schang266-crypto/Area-Efficient_GEMM_Core_for_Neural_Network_Inference_on_the_Edge/DesignDiagrams/fp16_adder_comparasin.png

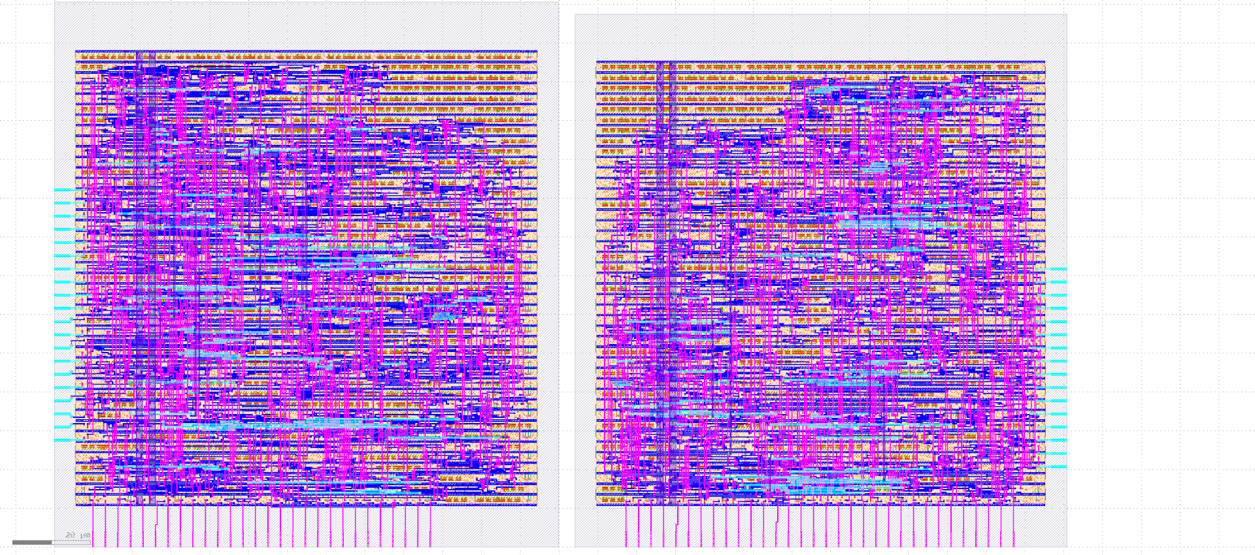
DesignDiagrams/fp16_adder_comparasin.png
