schang266-crypto/Area-Efficient_GEMM_Core_for_Neural_Network_Inference_on_the_Edge/DesignDiagrams/TOP2.png

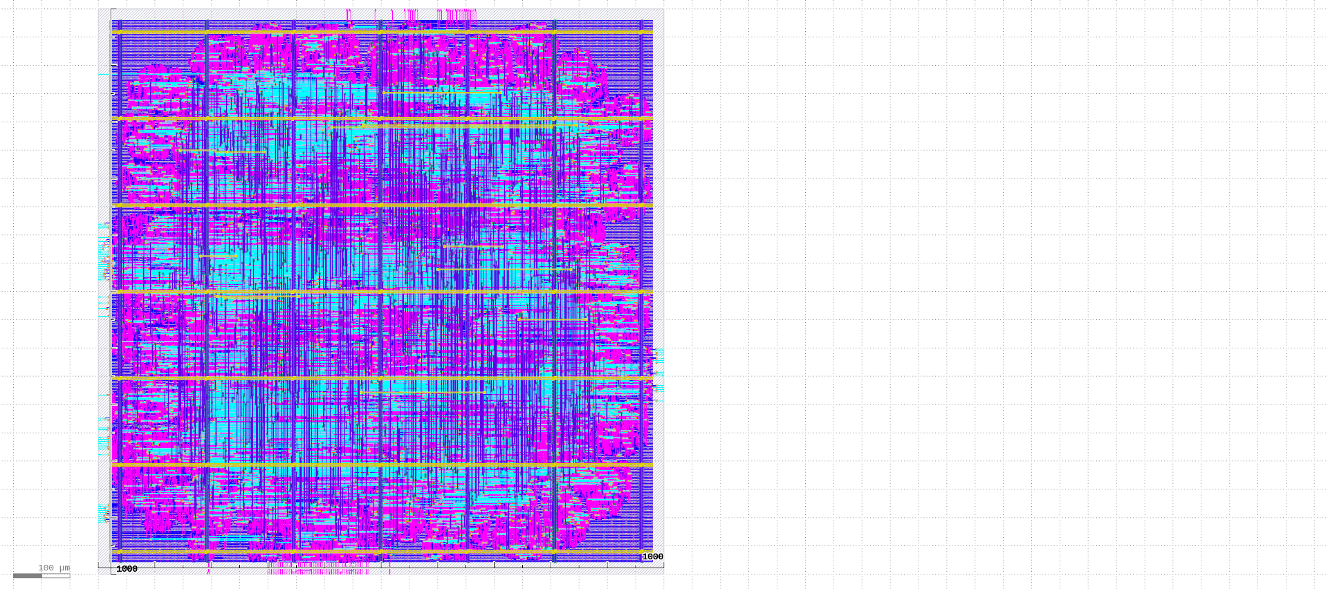
DesignDiagrams/TOP2.png
