schang266-crypto/Area-Efficient_GEMM_Core_for_Neural_Network_Inference_on_the_Edge/Synthesis/gemm_pe/gemm_pe.nl.v

module gemm_pe (clk,
    h_en_in,
    h_en_out,
    ld_bias,
    v_en_in,
    v_en_out,
    a_in,
    a_out,
    acc_out,
    bias,
    w_in,
    w_out);
 input clk;
 input h_en_in;
 output h_en_out;
 input ld_bias;
 input v_en_in;
 output v_en_out;
 input [3:0] a_in;
 output [3:0] a_out;
 output [15:0] acc_out;
 input [15:0] bias;
 input [3:0] w_in;
 output [3:0] w_out;

 wire _0000_;
 wire _0001_;
 wire _0002_;
 wire _0003_;
 wire _0004_;
 wire _0005_;
 wire _0006_;
 wire _0007_;
 wire _0008_;
 wire _0009_;
 wire _0010_;
 wire _0011_;
 wire _0012_;
 wire _0013_;
 wire _0014_;
 wire _0015_;
 wire _0016_;
 wire _0017_;
 wire _0018_;
 wire _0019_;
 wire _0020_;
 wire _0021_;
 wire _0022_;
 wire _0023_;
 wire _0024_;
 wire _0025_;
 wire _0026_;
 wire _0027_;
 wire _0028_;
 wire _0029_;
 wire _0030_;
 wire _0031_;
 wire _0032_;
 wire _0033_;
 wire _0034_;
 wire _0035_;
 wire _0036_;
 wire _0037_;
 wire _0038_;
 wire _0039_;
 wire _0040_;
 wire _0041_;
 wire _0042_;
 wire _0043_;
 wire _0044_;
 wire _0045_;
 wire _0046_;
 wire _0047_;
 wire _0048_;
 wire _0049_;
 wire _0050_;
 wire _0051_;
 wire _0052_;
 wire _0053_;
 wire _0054_;
 wire _0055_;
 wire _0056_;
 wire _0057_;
 wire _0058_;
 wire _0059_;
 wire _0060_;
 wire _0061_;
 wire _0062_;
 wire _0063_;
 wire _0064_;
 wire _0065_;
 wire _0066_;
 wire _0067_;
 wire _0068_;
 wire _0069_;
 wire _0070_;
 wire _0071_;
 wire _0072_;
 wire _0073_;
 wire _0074_;
 wire _0075_;
 wire _0076_;
 wire _0077_;
 wire _0078_;
 wire _0079_;
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
 sky130_fd_sc_hd__dfxtp_2 _2408_ (.CLK(clknet_2_2__leaf_clk),
    .D(_0022_),
    .Q(acc_out[6]));
 sky130_fd_sc_hd__dfxtp_2 _2409_ (.CLK(clknet_2_2__leaf_clk),
    .D(_0023_),
    .Q(acc_out[7]));
 sky130_fd_sc_hd__dfxtp_2 _2410_ (.CLK(clknet_2_2__leaf_clk),
    .D(_0024_),
    .Q(acc_out[8]));
 sky130_fd_sc_hd__dfxtp_2 _2411_ (.CLK(clknet_2_2__leaf_clk),
    .D(_0025_),
    .Q(acc_out[9]));
 sky130_fd_sc_hd__dfxtp_2 _2412_ (.CLK(clknet_2_0__leaf_clk),
    .D(_0026_),
    .Q(acc_out[10]));
 sky130_fd_sc_hd__dfxtp_2 _2413_ (.CLK(clknet_2_1__leaf_clk),
    .D(_0027_),
    .Q(acc_out[11]));
 sky130_fd_sc_hd__dfxtp_2 _2414_ (.CLK(clknet_2_0__leaf_clk),
    .D(_0028_),
    .Q(acc_out[12]));
 sky130_fd_sc_hd__dfxtp_2 _2415_ (.CLK(clknet_2_1__leaf_clk),
    .D(_0029_),
    .Q(acc_out[13]));
 sky130_fd_sc_hd__dfxtp_2 _2416_ (.CLK(clknet_2_1__leaf_clk),
    .D(_0030_),
    .Q(acc_out[14]));
 sky130_fd_sc_hd__dfxtp_2 _2417_ (.CLK(clknet_2_1__leaf_clk),
    .D(_0031_),
    .Q(\u_fp16_add.sb ));
 sky130_fd_sc_hd__dfxtp_2 _2418_ (.CLK(clknet_2_1__leaf_clk),
    .D(pe_en),
    .Q(pe_en_q));
 sky130_fd_sc_hd__dfxtp_2 _2419_ (.CLK(clknet_2_1__leaf_clk),
    .D(_0032_),
    .Q(\mul_out_q[7] ));
 sky130_fd_sc_hd__conb_1 _2420_ (.LO(_0000_));
 sky130_fd_sc_hd__buf_2 _2421_ (.A(\u_fp16_add.sb ),
    .X(acc_out[15]));
 sky130_fd_sc_hd__decap_3 PHY_EDGE_ROW_0_Right_0 ();
 sky130_fd_sc_hd__decap_3 PHY_EDGE_ROW_1_Right_1 ();
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
