schang266-crypto/Area-Efficient_GEMM_Core_for_Neural_Network_Inference_on_the_Edge/Synthesis/gemm_pe/gemm_pe.pnl.v

module gemm_pe (clk,
    h_en_in,
    h_en_out,
    ld_bias,
    v_en_in,
    v_en_out,
    VPWR,
    VGND,
    a_in,
    a_out,
    acc_out,
    bias,
    w_in,
    w_out);
 input clk;
 input h_en_in;
 output h_en_out;
 input ld_bias;
 input v_en_in;
 output v_en_out;
 inout VPWR;
 inout VGND;
 input [3:0] a_in;
 output [3:0] a_out;
 output [15:0] acc_out;
 input [15:0] bias;
 input [3:0] w_in;
 output [3:0] w_out;

 wire _0000_;
 wire _0001_;
 wire _0002_;
 wire _0003_;
 wire _0004_;
 wire _0005_;
 wire _0006_;
 wire _0007_;
 wire _0008_;
 wire _0009_;
 wire _0010_;
 wire _0011_;
 wire _0012_;
 wire _0013_;
 wire _0014_;
 wire _0015_;
 wire _0016_;
 wire _0017_;
 wire _0018_;
 wire _0019_;
 wire _0020_;
 wire _0021_;
 wire _0022_;
 wire _0023_;
 wire _0024_;
 wire _0025_;
 wire _0026_;
 wire _0027_;
 wire _0028_;
 wire _0029_;
 wire _0030_;
 wire _0031_;
 wire _0032_;
 wire _0033_;
 wire _0034_;
 wire _0035_;
 wire _0036_;
 wire _0037_;
 wire _0038_;
 wire _0039_;
 wire _0040_;
 wire _0041_;
 wire _0042_;
 wire _0043_;
 wire _0044_;
 wire _0045_;
 wire _0046_;
 wire _0047_;
 wire _0048_;
 wire _0049_;
 wire _0050_;
 wire _0051_;
 wire _0052_;
 wire _0053_;
 wire _0054_;
 wire _0055_;
 wire _0056_;
 wire _0057_;
 wire _0058_;
 wire _0059_;
 wire _0060_;
 wire _0061_;
 wire _0062_;
 wire _0063_;
 wire _0064_;
 wire _0065_;
 wire _0066_;
 wire _0067_;
 wire _0068_;
 wire _0069_;
 wire _0070_;
 wire _0071_;
 wire _0072_;
 wire _0073_;
 wire _0074_;
 wire _0075_;
 wire _0076_;
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
    .VPB(VPWR),
    .VPWR(VPWR),
    .Y(_0958_));
 sky130_fd_sc_hd__inv_2 _1880_ (.A(_0958_),
    .VGND(VGND),
    .VNB(VGND),
    .VPB(VPWR),
    .VPWR(VPWR),
    .Y(_0959_));
 sky130_fd_sc_hd__nand2_2 _1881_ (.A(_0940_),
    .B(_0744_),
    .VGND(VGND),
    .VNB(VGND),
    .VPB(VPWR),
    .VPWR(VPWR),
    .Y(_0960_));
 sky130_fd_sc_hd__nand3_2 _1882_ (.A(_0945_),
    .B(_0745_),
    .C(_0926_),
    .VGND(VGND),
    .VNB(VGND),
    .VPB(VPWR),
    .VPWR(VPWR),
    .Y(_0961_));
 sky130_fd_sc_hd__nand2_2 _1883_ (.A(_0960_),
    .B(_0961_),
    .VGND(VGND),
    .VNB(VGND),
    .VPB(VPWR),
    .VPWR(VPWR),
    .Y(_0962_));
 sky130_fd_sc_hd__nand2_2 _1884_ (.A(_0804_),
    .B(_0648_),
    .VGND(VGND),
    .VNB(VGND),
    .VPB(VPWR),
    .VPWR(VPWR),
    .Y(_0963_));
 sky130_fd_sc_hd__or2_2 _1885_ (.A(_0898_),
    .B(_0947_),
    .VGND(VGND),
    .VNB(VGND),
    .VPB(VPWR),
    .VPWR(VPWR),
    .X(_0964_));
 sky130_fd_sc_hd__nor2_2 _1886_ (.A(_0963_),
    .B(_0964_),
    .VGND(VGND),
    .VNB(VGND),
    .VPB(VPWR),
    .VPWR(VPWR),
    .Y(_0965_));
 sky130_fd_sc_hd__nand3_2 _1887_ (.A(_0920_),
    .B(_0923_),
    .C(_0924_),
    .VGND(VGND),
    .VNB(VGND),
    .VPB(VPWR),
    .VPWR(VPWR),
    .Y(_0966_));
 sky130_fd_sc_hd__o21ai_2 _1888_ (.A1(_0965_),
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
