schang266-crypto/Area-Efficient_GEMM_Core_for_Neural_Network_Inference_on_the_Edge/Verification/tb/gemm_pkg.sv

///////////////////////////////////////////////////////////////////////////////
// Package: gemm_pkg.sv
// Description: Shared parameters for the GEMM Core design. Defines all
//              bitwidths, addresses, and depths used across modules.
// Author: Group5
///////////////////////////////////////////////////////////////////////////////

package gemm_pkg;

    // Internal FSM State Encoding
        typedef enum logic [1:0] {
            IDLE         = 2'b00,
            LOAD_FIFO    = 2'b01,
            GEMM_COMPUTE = 2'b10,
            GEMM_FLUSH   = 2'b11
        } gemm_state_t;

    // ── Systolic Array Dimensions ─────────────────────────────────────────
    localparam int ARRAY_SIZE       = 8;    // 8x8 systolic array

    // ── Data Bitwidths ────────────────────────────────────────────────────
    localparam int ACT_WIDTH        = 4;    // activation input bitwidth
    localparam int WGT_WIDTH        = 4;    // weight input bitwidth
    localparam int ACC_WIDTH        = 16;   // accumulator / MAC output bitwidth
    localparam int OUT_WIDTH        = 4;    // quantized output bitwidth

    // ── FIFO Parameters ───────────────────────────────────────────────────
    localparam int FIFO_DEPTH       = 8;    // entries per FIFO (one per k-slice)
    localparam int FIFO_ADDR_WIDTH  = $clog2(FIFO_DEPTH);  // 3-bit address

    // ── Dimension Encoding ────────────────────────────────────────────────
    localparam int DIM_WIDTH        = 4;    // 4-bit dimension inputs {1-8}

    // ── Control Counter Widths ────────────────────────────────────────────
    localparam int MAIN_CNT_WIDTH   = 5;    // main_cnt: covers A+W+K-3 max=21
    localparam int BIAS_CNT_WIDTH   = 4;    // bias_cnt: covers W_DIM max=8
endpackage
